IowaScaledEngineering/mss-switch/README.md

# mss-switch
ISE SimpleSig Switch Signal Basic
MSS Complex Cascade Node
