IowaScaledEngineering/mss-switch/pg/mss-switch-v1.1-8196500/mss-switch.pdf

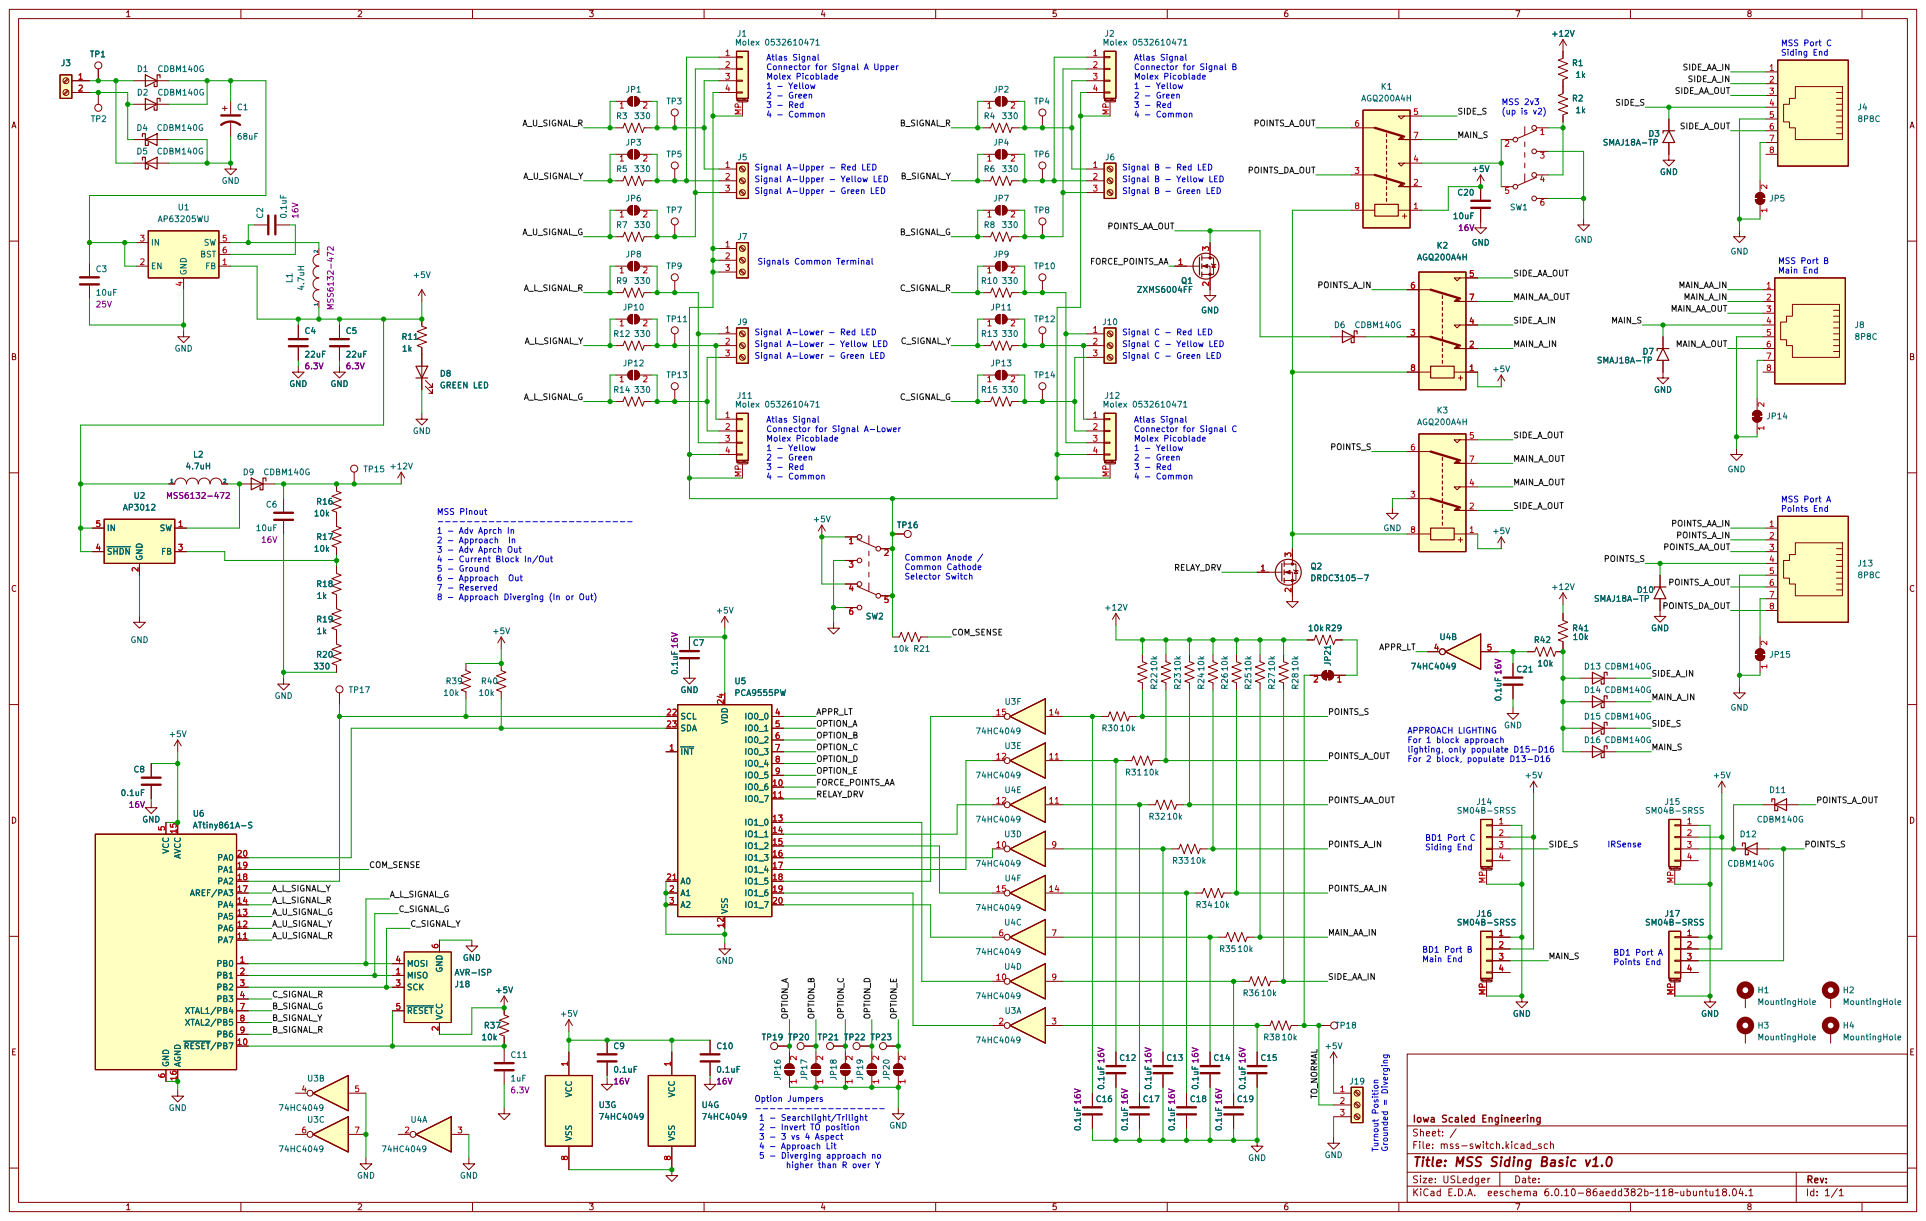
[picture p1: page 1]

Atlas Signal
Connector for Signal A Upper Molex Picoblade

Connector for Signal B Molex Picoblade

Signal A-Lower - Green LED MSS Pinout --------------------------- 1 - Adv Aprch In

Points End Common Anode / Common Cathode Selector Switch Atlas Signal
Connector for Signal A-Lower Molex Picoblade

Connector for Signal C Molex Picoblade

Points End Option Jumpers

2 - Approach In
3 - Adv Aprch Out 4 - Current Block In/Out 5 - Ground

2 SCK 3 MOSI 4 ~{RESET} 5 GND

Iowa Scaled Engineering
File: mss-switch.kicad_sch Sheet: /
Id: 1/1 Title: MSS Siding Basic v1.0
