IowaScaledEngineering/mss-switch/pg/mss-switch-v1.2-143173d/mss-switch.pdf

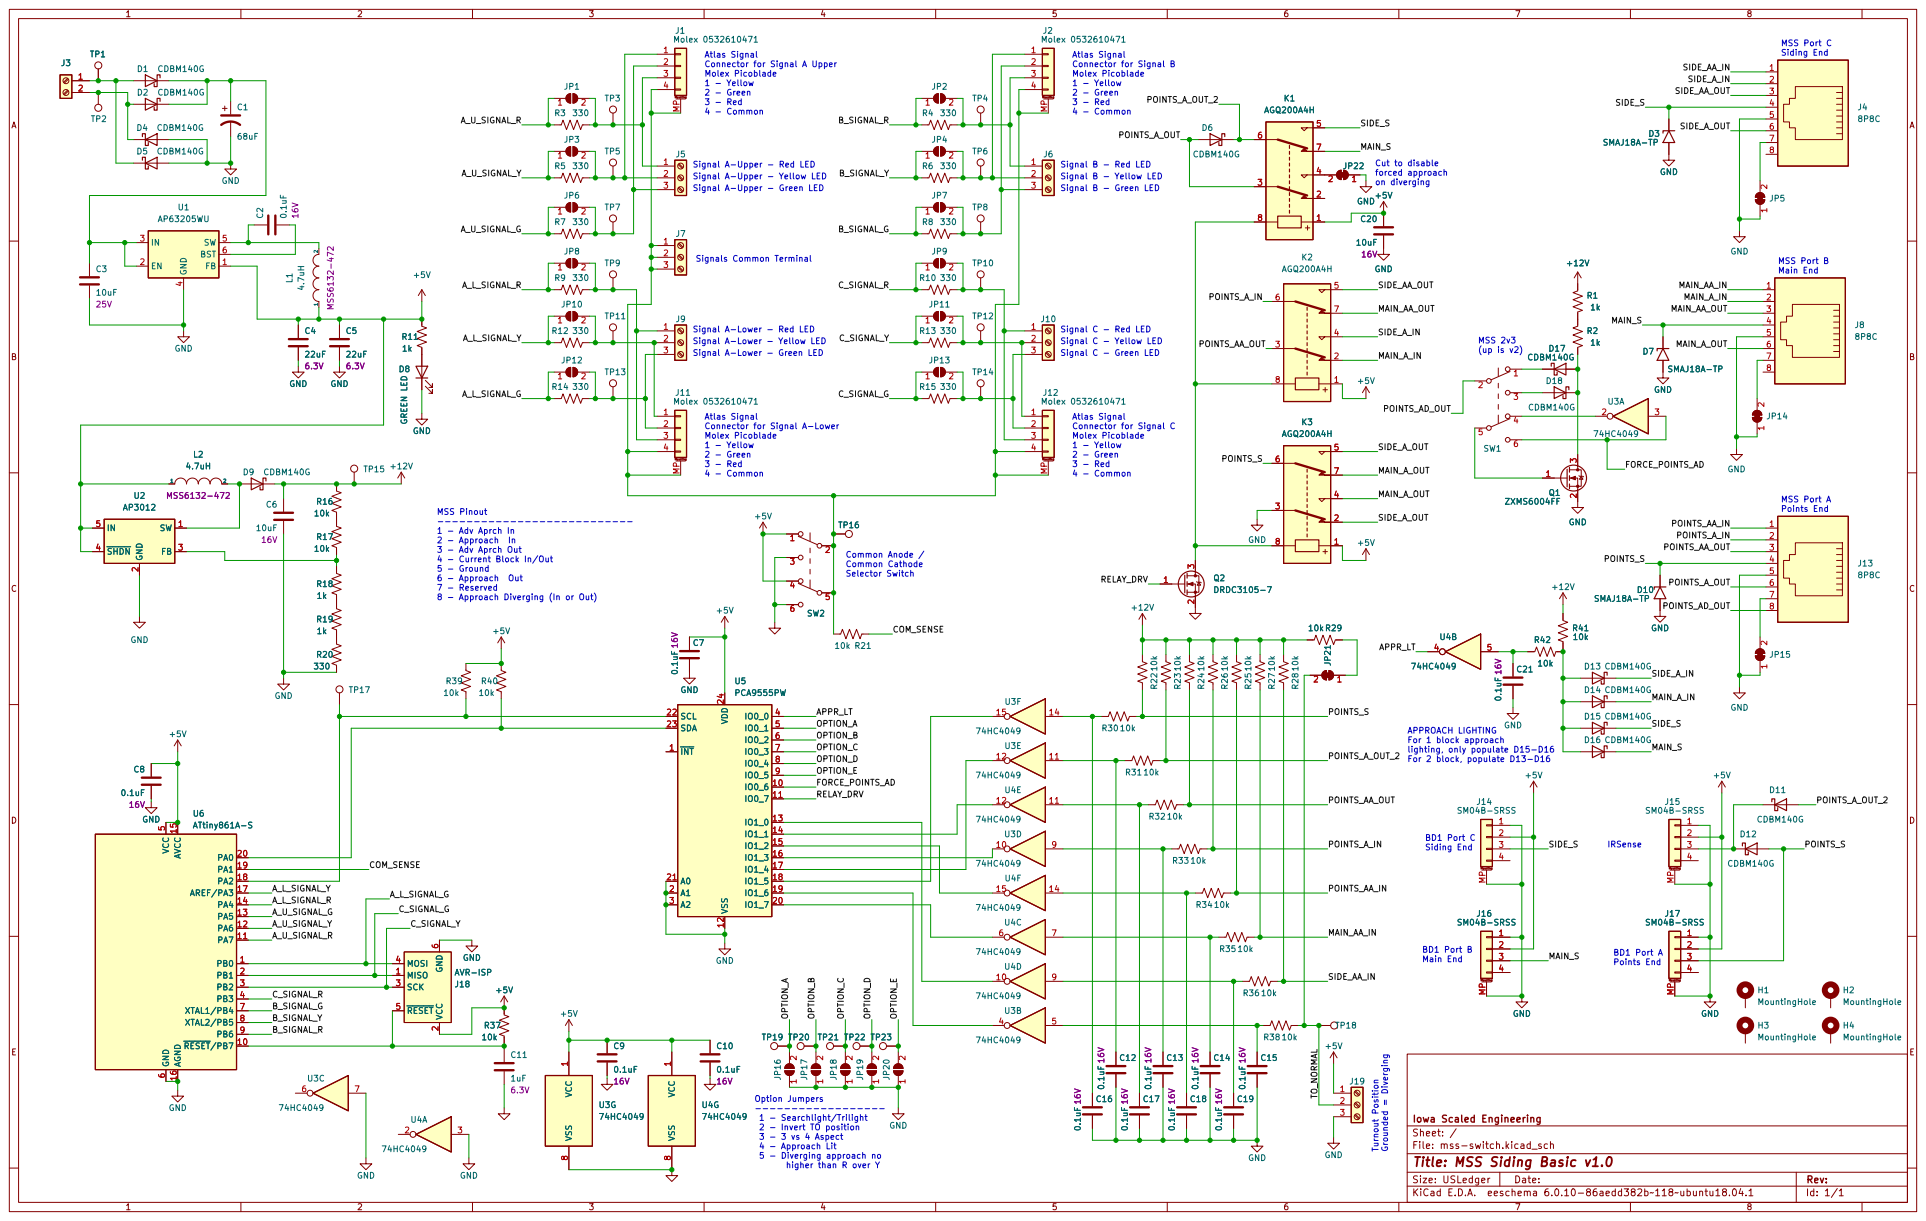
[picture p2: page 1]

Atlas Signal
Connector for Signal A Upper Molex Picoblade

Connector for Signal B Molex Picoblade

Connector for Signal A-Lower Molex Picoblade

Connector for Signal C Molex Picoblade

4 - Common MSS Pinout --------------------------- 1 - Adv Aprch In

2 - Approach In
3 - Adv Aprch Out 4 - Current Block In/Out 5 - Ground

2 SCK 3 MOSI 4 ~{RESET} 5 GND

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
