IowaScaledEngineering/mss-switch/pg/mss-siding-v1.0-1123d20/mss-siding.pdf

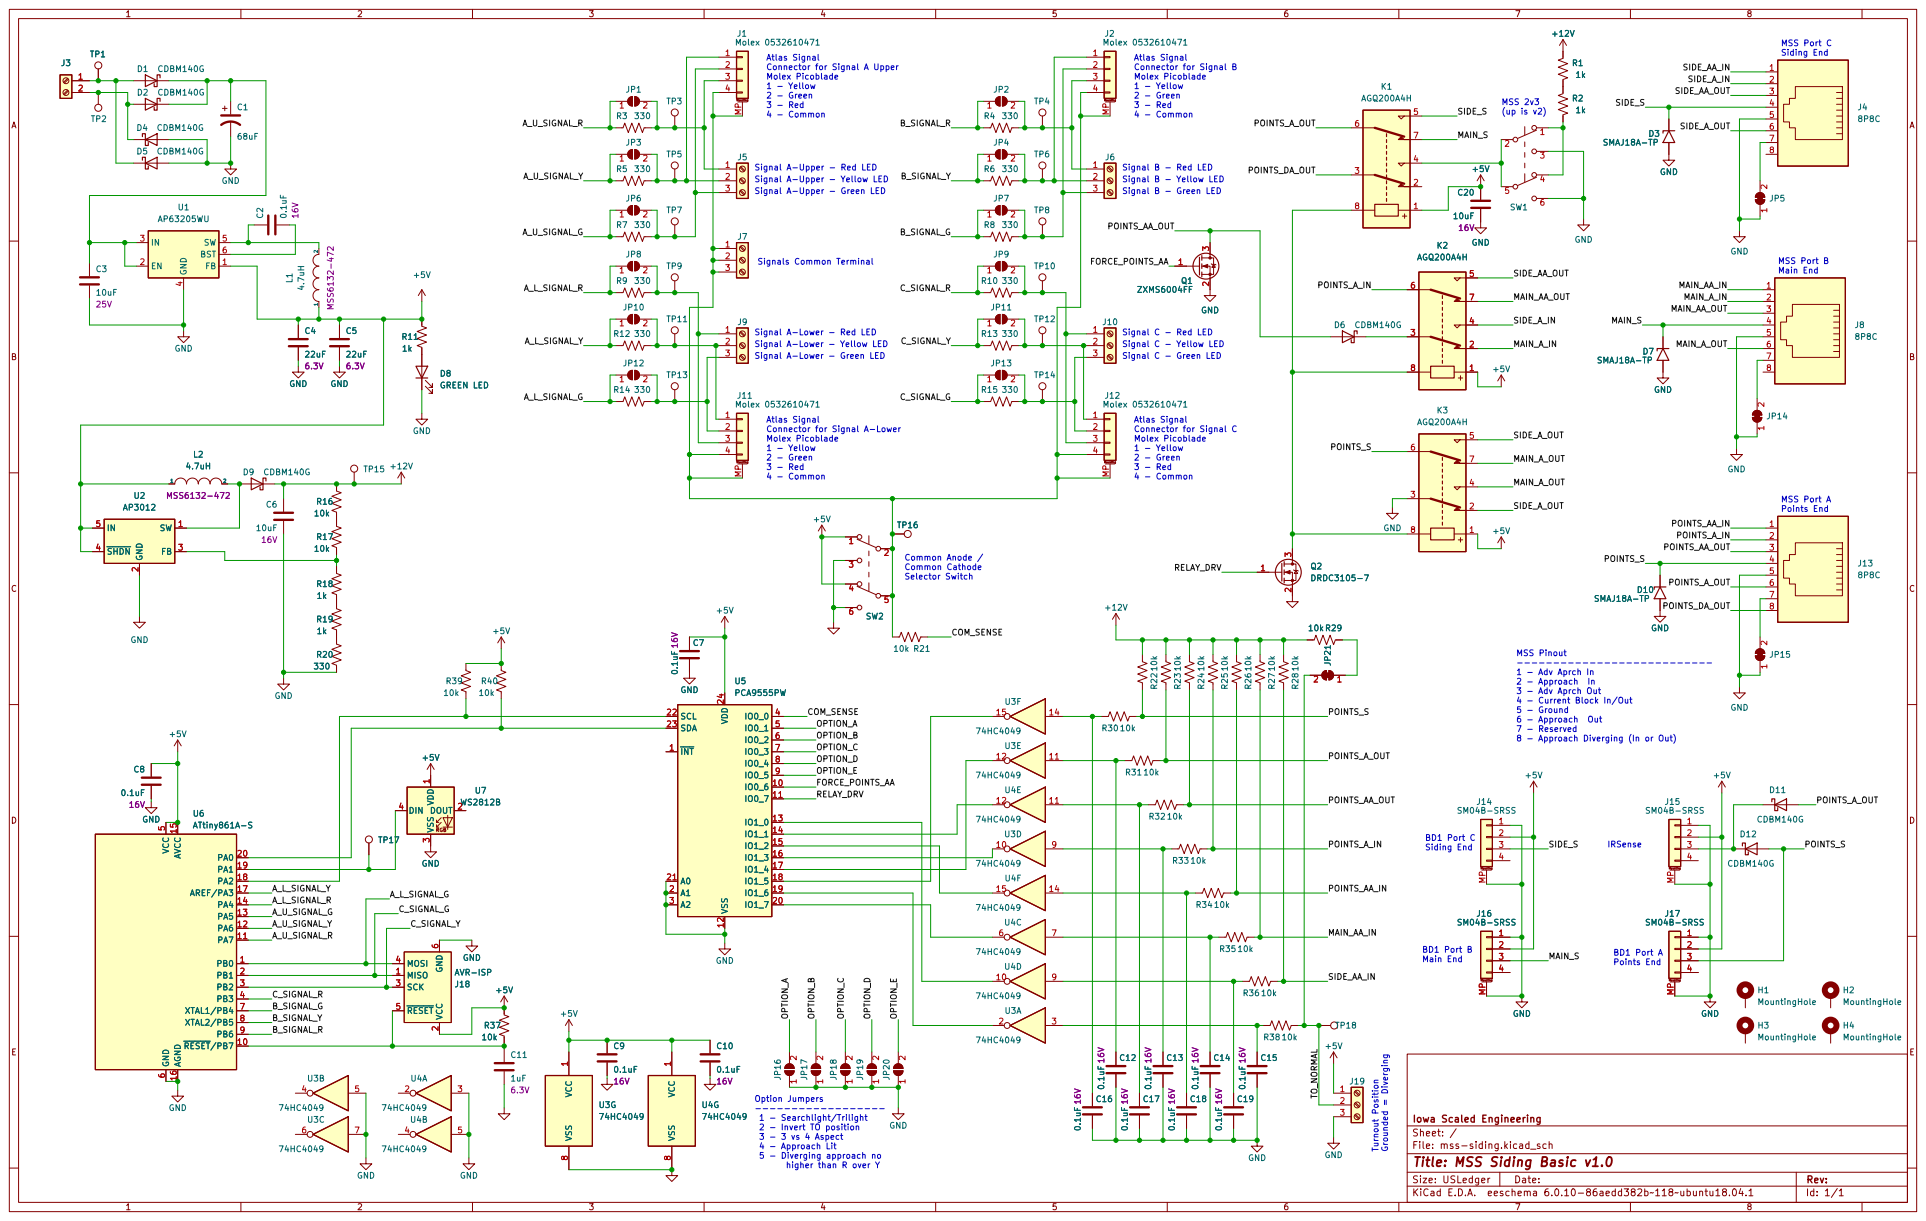
[picture p3: page 1]

Atlas Signal
Connector for Signal A Upper Molex Picoblade

Connector for Signal B Molex Picoblade

4 - Common Signal B - Green LED

Signal A-Upper - Red LED
Points End Signal A-Upper - Green LED

Connector for Signal A-Lower Molex Picoblade

Connector for Signal C Molex Picoblade

2 - Approach In
3 - Adv Aprch Out 4 - Current Block In/Out 5 - Ground

8 - Approach Diverging (In or Out)

2 SCK 3 MOSI 4 ~{RESET} 5 GND

Iowa Scaled Engineering
File: mss-siding.kicad_sch Sheet: /
Id: 1/1 Title: MSS Siding Basic v1.0
