IowaScaledEngineering/mss-switch/src/mss-switch.c

/*************************************************************************
Title:    MSS-SWITCH
Authors:  Michael Petersen <railfan@drgw.net>
          Nathan D. Holmes <maverick@drgw.net>
File:     $Id: $
License:  GNU General Public License v3

LICENSE:
    Copyright (C) 2025 Michael Petersen & Nathan Holmes

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
*************************************************************************/

#include <avr/io.h>
#include <avr/interrupt.h>
#include <avr/wdt.h>
#include <util/delay.h>
#include <util/atomic.h>

#include <avr/sleep.h>
#include <stdbool.h>
#include <stdint.h>

#include "debouncer.h"
#include "signalHead.h"
#include "mss.h"
#include "i2c.h"
#include "hardware.h"

#define MIN(a,b) ((a)<(b)?(a):(b))
#define MAX(a,b) ((a)>(b)?(a):(b))

volatile uint8_t signalHeadOptions = 0;
volatile uint32_t millis = 0;
SignalState_t signalAU;
SignalState_t signalAL;
SignalState_t signalB;
SignalState_t signalC;

void calculateAspects(uint8_t mssInputs, uint8_t optionJumpers);

uint32_t getMillis()
{
	uint32_t retmillis;
	ATOMIC_BLOCK(ATOMIC_RESTORESTATE) 
	{
		retmillis = millis;
	}
	return retmillis;
}

ISR(TIMER0_COMPA_vect) 
{
	static uint8_t flasherCounter = 0;
	static uint8_t flasher = 0;
	static uint8_t pwmPhase = 0;
	static uint8_t subMillisCounter = 0;
	
	// The ISR does two main things - updates the LED outputs since
	//  PWM is done through software, and updates millis which is used
	//  to trigger various events
	// We need this to run at roughly 125 Hz * number of PWM levels (32).  That makes a nice round 4kHz
	
	// First thing, output the signals so that the PWM doesn't get too much jitter

	signalHeadISR_OutputPWM(&signalAU, signalHeadOptions, pwmPhase, SIGNAL_HEAD_AU_DEF);
	signalHeadISR_OutputPWM(&signalAL, signalHeadOptions, pwmPhase, SIGNAL_HEAD_AL_DEF);
	signalHeadISR_OutputPWM(&signalB, signalHeadOptions, pwmPhase, SIGNAL_HEAD_B_DEF);
	signalHeadISR_OutputPWM(&signalC, signalHeadOptions, pwmPhase, SIGNAL_HEAD_C_DEF);

	// Now do all the counter incrementing and such
	if (++subMillisCounter >= 4)
	{
		subMillisCounter = 0;
		millis++;
	}

	pwmPhase = (pwmPhase + 1) & 0x1F;

	if (0 == pwmPhase)
	{
		pwmPhase = 0;
		flasherCounter++;
		if (flasherCounter > 94)
		{
			flasher ^= 0x01;
			flasherCounter = 0;
		}

		// We rolled over the PWM counter, calculate the next PWM widths
		// This runs at 125 frames/second essentially

		signalHeadISR_AspectToNextPWM(&signalAU, flasher, signalHeadOptions);
		signalHeadISR_AspectToNextPWM(&signalAL, flasher, signalHeadOptions);
		signalHeadISR_AspectToNextPWM(&signalB, flasher, signalHeadOptions);
		signalHeadISR_AspectToNextPWM(&signalC, flasher, signalHeadOptions);
	}
}

void initializeTimer()
{
	TIMSK = 0;                                    // Timer interrupts OFF
	// Set up Timer/Counter0 for 100Hz clock
	TCCR0A = 0b00000001;  // CTC Mode
	TCCR0B = 0b00000010;  // CS01 - 1:8 prescaler
	OCR0A = 250;           // 8MHz / 8 / 250 = 4kHz
	TIMSK = _BV(OCIE0A);
}

int main(void)
{
	DebounceState8_t optionsDebouncer;
	DebounceState8_t mssDebouncer;
	uint32_t lastReadTime = 0xf0000000;
	uint32_t currentTime = 0;
	uint8_t lastMSSInputs = 0;
	uint8_t turnoutChangeLockout = (STARTUP_LOCKOUT_TIME_MS)/(LOOP_UPDATE_TIME_MS);
	uint8_t initValue=0, i=0;
	
	// Deal with watchdog first thing
	MCUSR = 0;              // Clear reset status
	wdt_reset();            // Reset the WDT, just in case it's still enabled over reset
	wdt_enable(WDTO_1S);    // Enable it at a 1S timeout.

	// PORT A
	//  PA7 - Output - A Upper Signal - RED
	//  PA6 - Output - A Upper Signal - YELLOW
	//  PA5 - Output - A Upper Signal - GREEN
	//  PA4 - Output - A Lower Signal - RED
	//  PA3 - Output - A Lower Signal - YELLOW
	//  PA2 - I2C    - SCL
	//  PA1 - Input  - Common Connection Sense
	//  PA0 - I2C    - SDA

	// PORT B
	//  PB7 - n/a    - /RESET (not I/O pin)
	//  PB6 - Output - B Signal - RED
	//  PB5 - Output - B Signal - YELLOW
	//  PB5 - Output - B Signal - GREEN
	//  PB3 - Output - C Signal - RED
	//  PB2 - Output - C Signal - YELLOW
	//  PB1 - Output - C Signal - GREEN
	//  PB0 - Output - A Lower Signal - GREEN

	PORTA = 0b11111111;
	DDRA  = 0b11111100;

	PORTB = 0b11111111;
	DDRB  = 0b01111111;

	initializeTimer();

	signalHeadInitialize(&signalAU);
	signalHeadInitialize(&signalAL);
	signalHeadInitialize(&signalB);
	signalHeadInitialize(&signalC);

	signalHeadAspectSet(&signalAU, ASPECT_OFF);
	signalHeadAspectSet(&signalAL, ASPECT_OFF);
	signalHeadAspectSet(&signalB, ASPECT_OFF);
	signalHeadAspectSet(&signalC, ASPECT_OFF);

	wdt_reset();

	// Set TCA9555 direction registers
	writeByte(TCA9555_ADDR_000, TCA9555_GPDDR0, 0b00111111);
	writeByte(TCA9555_ADDR_000, TCA9555_GPDDR1, 0b11111111);
	writeByte(TCA9555_ADDR_000, TCA9555_GPOUT0, 0b00000000);

	// Now that the IO expander and such as had a little time to settle
	//  go get the initial values for options and MSS.  This should avoid
	//  most of the initial bouncing around as the module starts up.

	initValue = OPTION_COMMON_ANODE | OPTION_B_FOUR_ASPECT; // Default is common anode, four aspect
	if (readByte(TCA9555_ADDR_000, TCA9555_GPIN0, &i))
		initValue = i;
	// In rev 1.1, common sense moved from the IO expander to GPIO
	initValue &= ~(OPTION_COMMON_ANODE);
	initValue |= ((PINA & 0x02)?OPTION_COMMON_ANODE:0);

	initDebounceState8(&optionsDebouncer, initValue);

	// Convert global option bits to signal head option bits
	if (initValue & OPTION_C_SEARCHLIGHT_MODE)
		signalHeadOptions |= SIGNAL_OPTION_SEARCHLIGHT;
	else 
		signalHeadOptions &= ~SIGNAL_OPTION_SEARCHLIGHT;

	if (initValue & OPTION_COMMON_ANODE)
		signalHeadOptions |= SIGNAL_OPTION_COMMON_ANODE;
	else 
		signalHeadOptions &= ~SIGNAL_OPTION_COMMON_ANODE;

	initValue = 0; // Default - all lines clear, turnout normal
	if (readByte(TCA9555_ADDR_000, TCA9555_GPIN1, &i))
		initValue = i;
	initDebounceState8(&mssDebouncer, initValue);




	sei();

	while(1)
	{
		wdt_reset();

		currentTime = getMillis();

		// We really don't need or want updates very often
		//  50mS or so should be fine.  
		if (((uint32_t)currentTime - lastReadTime) > LOOP_UPDATE_TIME_MS)
		{
			uint8_t optionJumpers = 0;
			uint8_t mssInputs = 0;
			bool turnoutChanged = false;
			lastReadTime = currentTime;

			// Read PCA9555
			//  Note: readByte returns whether we got an ack
			//  Only use the data on a valid read
			if (readByte(TCA9555_ADDR_000, TCA9555_GPIN0, &i))
			{
				// In rev 1.1, common sense moved from the IO expander to GPIO
				i &= ~(OPTION_COMMON_ANODE);
				i |= ((PINA & 0x02)?OPTION_COMMON_ANODE:0);
				debounce8(i, &optionsDebouncer);
			}

			if (readByte(TCA9555_ADDR_000, TCA9555_GPIN1, &i))
				debounce8(i, &mssDebouncer);

			// Read state of MSS bus ports coming in
			mssInputs = getDebouncedState(&mssDebouncer);

			// Read state of option jumpers
			optionJumpers = getDebouncedState(&optionsDebouncer);
			// Options A-E are inverted (pulled up if open, low if soldered)
			//  If they're selected, they're low.  Just invert them here so I
			//  don't have to constantly think backwards
			optionJumpers ^= 0b00111110;

			if ((lastMSSInputs ^ mssInputs) & MSS_TO_IS_DIVERGING)
			{
				turnoutChangeLockout = (TURNOUT_LOCKOUT_TIME_MS) / (LOOP_UPDATE_TIME_MS);
				turnoutChanged = true;
			}
			lastMSSInputs = mssInputs;

			// If ou want to fake the optionJumper settings for testing, do it here
			// optionJumpers |= OPTION_B_FOUR_ASPECT | OPTION_C_SEARCHLIGHT_MODE | OPTION_D_LIMIT_DIVERGING | OPTION_A_APPROACH_LIGHTING;

			// Convert global option bits to signal head option bits
			if (optionJumpers & OPTION_C_SEARCHLIGHT_MODE)
				signalHeadOptions |= SIGNAL_OPTION_SEARCHLIGHT;
			else 
				signalHeadOptions &= ~SIGNAL_OPTION_SEARCHLIGHT;

			if (optionJumpers & OPTION_COMMON_ANODE)
				signalHeadOptions |= SIGNAL_OPTION_COMMON_ANODE;
			else 
				signalHeadOptions &= ~SIGNAL_OPTION_COMMON_ANODE;

			// Calculate the output settings.  Basically, should we set the signal 
			//  routing relay on (turnout to siding) or off (turnout to main)
			// In addition, if we are thrown to the siding and Option D (limit diverging indication
			//  to diverging approach) is set, figure out if we should send the 
			//  advance approach indication down the line.  
			{
				uint8_t updateOutputs = 0;
				if (mssInputs & MSS_TO_IS_DIVERGING)
					updateOutputs |= MSS_SET_ROUTE_RELAY;

				// If the points are set diverging and we're *NOT* going to display a stop
				//  indication, set the approach diverging line

				if (turnoutChanged)
				{
					// If the turnout just flopped over, we don't want to glitch and send the wrong
					//  approach diverging.  So we're going to write the new relay state, wait about 5 time constants
					//  and then read the MSS bus state and make that the current state
					
					// Set the relay driver appropriately
					writeByte(TCA9555_ADDR_000, TCA9555_GPOUT0, updateOutputs);

					_delay_ms(5); //  Wait 5ms - plenty of time constants to stabilize

					// Read four times to get the new input values
					if (readByte(TCA9555_ADDR_000, TCA9555_GPIN1, &i))
						debounce8(i, &mssDebouncer);
					if (readByte(TCA9555_ADDR_000, TCA9555_GPIN1, &i))
						debounce8(i, &mssDebouncer);
					if (readByte(TCA9555_ADDR_000, TCA9555_GPIN1, &i))
						debounce8(i, &mssDebouncer);
					if (readByte(TCA9555_ADDR_000, TCA9555_GPIN1, &i))
						debounce8(i, &mssDebouncer);
					mssInputs = getDebouncedState(&mssDebouncer);
				}

				if ((mssInputs & MSS_TO_IS_DIVERGING) && !(mssInputs & MSS_POINTS_A_OUT))
					updateOutputs |= MSS_SET_APPROACH_DIVERGING;

				
				writeByte(TCA9555_ADDR_000, TCA9555_GPOUT0, updateOutputs);
			}

			// If the turnout just changed, we need to give the relays time to settle down
			//  and the new signal states to propagate through the debouncer.  Otherwise, calculate
			//  the new aspects based on what came out of the debouncers

			if (!turnoutChangeLockout)
				calculateAspects(mssInputs, optionJumpers);
			else
				turnoutChangeLockout--;
		}
	}
}


void calculateAspects(uint8_t mssInputs, uint8_t optionJumpers)
{
	SignalAspect_t aspectAU = ASPECT_RED;
	SignalAspect_t aspectAL = ASPECT_RED;
	SignalAspect_t aspectB = ASPECT_RED;
	SignalAspect_t aspectC = ASPECT_RED;

	// Calculate signal aspects directly, since we don't have neatly-terminated
	//  MSS busses but rather have to glean states from combinations of things.

	// SIGNAL A - Points End

	if (mssInputs & MSS_TO_IS_DIVERGING)
	{
		// Diverging point end signals
		aspectAU = ASPECT_RED;
	
		if (mssInputs & MSS_POINTS_A_OUT)
			aspectAL = ASPECT_RED;
		else if ((mssInputs & MSS_POINTS_AA_OUT) || (optionJumpers & OPTION_D_LIMIT_DIVERGING))
			aspectAL = ASPECT_YELLOW;
		else if ((mssInputs & MSS_SIDING_AA_IN) && (optionJumpers & OPTION_B_FOUR_ASPECT))
			aspectAL = ASPECT_FL_YELLOW;
		else
			aspectAL = ASPECT_GREEN;			

	} else {
		aspectAL = ASPECT_RED;

		if (mssInputs & MSS_POINTS_A_OUT)
			aspectAU = ASPECT_RED;
		else if (mssInputs & MSS_POINTS_AA_OUT)
			aspectAU = ASPECT_YELLOW;
		else if ((mssInputs & MSS_MAIN_AA_IN ) && (optionJumpers & OPTION_B_FOUR_ASPECT))
			aspectAU = ASPECT_FL_YELLOW;
		else
			aspectAU = ASPECT_GREEN;
	}

	// SIGNAL B - Frog End, Normal (Main)

	if ((mssInputs & MSS_POINTS_S) || (mssInputs & MSS_TO_IS_DIVERGING))
		aspectB = ASPECT_RED;
	else if (mssInputs & MSS_POINTS_A_IN)
		aspectB = ASPECT_YELLOW;
	else if ((mssInputs & MSS_POINTS_AA_IN) && (optionJumpers & OPTION_B_FOUR_ASPECT))
		aspectB = ASPECT_FL_YELLOW;
	else
		aspectB = ASPECT_GREEN;

	// SIGNAL C - Frog End, Diverging/Reverse (Siding)

	if (mssInputs & MSS_POINTS_S || !(mssInputs & MSS_TO_IS_DIVERGING))
		aspectC = ASPECT_RED;
	else if (mssInputs & MSS_POINTS_A_IN)
		aspectC = ASPECT_YELLOW;
	else if ((mssInputs & MSS_POINTS_AA_IN) && (optionJumpers & OPTION_B_FOUR_ASPECT))
		aspectC = ASPECT_FL_YELLOW;
	else
		aspectC = ASPECT_GREEN;


	// Handle approach lighting.  If we're approach lit, turn everything off unless there's
	//  something in an adjacent block
	if (optionJumpers & OPTION_A_APPROACH_LIGHTING)
	{
		if (!((mssInputs & MSS_POINTS_S) || (optionJumpers & MSS_APPROACH_LT_INPUT)))
		{
			// If nothing is in any of the adjacent blocks, turn signals off
			aspectAL = aspectAU = aspectB = aspectC = ASPECT_OFF;
		}
	}



	signalHeadAspectSet(&signalAU, aspectAU);
	signalHeadAspectSet(&signalAL, aspectAL);
	signalHeadAspectSet(&signalB, aspectB);
	signalHeadAspectSet(&signalC, aspectC);
}
