IowaScaledEngineering/mss-switch/src/mss.c

/*************************************************************************
Title:    Modular Signal System Support Library
Authors:  Michael Petersen <railfan@drgw.net>
          Nathan D. Holmes <maverick@drgw.net>
File:     mss.c
License:  GNU General Public License v3

LICENSE:
    Copyright (C) 2024 Michael Petersen & Nathan Holmes

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
*************************************************************************/

#include "mss.h"


void mssPortInitialize(MSSPort_t* port)
{
	initDebounceState8(&port->debounce, 0x00);
	port->indication = INDICATION_STOP;
}

bool mssPortApproach(MSSPort_t* port)
{
	switch(port->indication)
	{
		case INDICATION_STOP:
		case INDICATION_APPROACH:
			return true;

		default:
			break;
	}
	return false;
}

void mssReadPort(MSSPort_t* port, volatile uint8_t* adjacentPort, uint8_t adjacentMask,
	volatile uint8_t* approachPort, uint8_t approachMask,
	volatile uint8_t* advApproachPort, uint8_t advApproachMask,
	volatile uint8_t* divApproachPort, uint8_t divApproachMask)
{
	uint8_t mssInputState = 0;
	
	if ( *adjacentPort & adjacentMask )
		mssInputState |= MSS_MASK_ADJACENT;

	if ( *approachPort & approachMask )
		mssInputState |= MSS_MASK_APPROACH;

	if ( *advApproachPort & advApproachMask )
		mssInputState |= MSS_MASK_ADV_APPROACH;
		
	if ( divApproachPort && (*divApproachPort & divApproachMask) )
		mssInputState |= MSS_MASK_DIV_APPROACH;

	debounce8(mssInputState, &(port->debounce));

	mssInputState = getDebouncedState(&(port->debounce));
	
	if (mssInputState & MSS_MASK_ADJACENT)
	{
		port->indication = INDICATION_STOP;
	}
	else if (mssInputState & MSS_MASK_APPROACH)
	{
		if (mssInputState & MSS_MASK_DIV_APPROACH)
			port->indication = INDICATION_APPROACH_DIVERGING;
		else
			port->indication = INDICATION_APPROACH;
	}
	else if (mssInputState & MSS_MASK_ADV_APPROACH)
	{
		port->indication = INDICATION_ADVANCE_APPROACH;
	}
	else
	{
		port->indication = INDICATION_CLEAR;
	}
}

void mssIndicationToSingleHeadAspect(MSSPortIndication_t indication, SignalAspect_t* aspect, uint8_t options, bool approachActive)
{
	// If we're approach lit and there's nothing on approach, turn off
	if (!approachActive && (options & MSS_ASPECT_OPTION_APPRCH_LIGHTING))
	{
		*aspect = ASPECT_OFF;
		return;
	}

	switch (indication)
	{
		case INDICATION_STOP:
		default:
			*aspect = ASPECT_RED;
			break;

		case INDICATION_APPROACH:
		case INDICATION_APPROACH_DIVERGING:
			*aspect = ASPECT_YELLOW;
			break;

		case INDICATION_ADVANCE_APPROACH:
			*aspect = (options & MSS_ASPECT_OPTION_FOUR_INDICATION)?ASPECT_FL_YELLOW:ASPECT_GREEN;
			break;

		case INDICATION_CLEAR:
			*aspect = ASPECT_GREEN;
			break;
	}
}
