IowaScaledEngineering/mss-switch/(commit log)

2024-09-11 Add initial cut of siding schematic
    [Siding Truth Tables.ods, mss-siding.kicad_pcb, mss-siding.kicad_sch]
2024-09-12 Add relay part number
    [mss-siding.kicad_sch]
2024-09-25 First cut of PCB
    [mss-siding.kicad_pcb, mss-siding.kicad_sch]
2024-09-25 Update 3D models for render
    [mss-siding.kicad_pcb]
2024-09-25 Fix a couple more booboos
    [mss-siding.kicad_pcb, mss-siding.kicad_sch]
2024-09-26 Add I2C pull up resistors Fix some text issues
    [mss-siding.kicad_pcb, mss-siding.kicad_sch]
2024-09-27 Design review improvements
    [mss-siding.kicad_pcb, mss-siding.kicad_sch]
2024-09-27 PG 1.0
    [mss-siding-NPTH.drl, mss-siding.drl, mss-siding.gbl, mss-siding.gbo, mss-siding.gbp, mss-siding.gbr, mss-siding.gbs, mss-siding.gm1]
2024-10-10 Initial cut of the code - i2c doesn't work yet
    [i2c.c, i2c.h, mss.c, mss.h]
2024-10-11 Work on v1.1 that adds the lines needed for approach lighting on the frog end.
    [mss-siding.kicad_pcb, mss-siding.kicad_sch]
2024-10-12 Pretty close to working actual firmware for a v1.0 board
2024-10-24 Add connector models
    [mss-siding.kicad_pcb]
2024-10-24 Add start of the siding test harness
    [mss-siding-test.kicad_pcb, mss-siding-test.kicad_sch]
2024-11-10 More renaming fun
    [Siding Truth Tables.ods, mss-siding-test.kicad_pcb, mss-siding-test.kicad_sch, mss-switch.kicad_pcb, mss-switch.kicad_sch]
2024-11-10 Update PCB to say mss-switch
    [mss-switch.kicad_pcb]
2024-12-20 Update to work on v1.1 hardware and do approach lighting correctly
    [hardware.h, mss-switch.c]
2024-12-26 Potential fix for diverging problem
    [mss-switch.kicad_sch]
2024-12-26 Fix issue where the BD1 wasn't going into the right A_OUT net
    [mss-switch.kicad_sch]
2024-12-27 Updates to finally (hopefully) fix approach diverging
    [mss-switch.kicad_pcb, mss-switch.kicad_sch]
2024-12-27 Update version and copyright date to 1.2/2025
    [mss-switch.kicad_pcb]
2024-12-31 Move some text around per MDP just to be cleaner
    [mss-switch.kicad_pcb]
2024-12-31 PG v1.1 and 1.2
    [mss-switch-NPTH.drl, mss-switch.drl, mss-switch.gbl, mss-switch.gbo, mss-switch.gbp, mss-switch.gbr, mss-switch.gbs, mss-switch.gm1]
2025-01-20 Fix for approach diverging glitching on change
    [mss-switch.c]
2025-01-23 Fix issue where CA/CC doesn't work - broken in v1.1
    [mss-switch.c]
