IowaScaledEngineering/mss-switch/(notices)

Notices in the files:
kicad/mss-switch/mss-switch.kicad_pcb:
©2025
kicad/mss-switch-test/mss-siding-test.kicad_pcb:
©2024
